Trinhduccuongdz/smart-lamp/docs/1_block_diagram.png

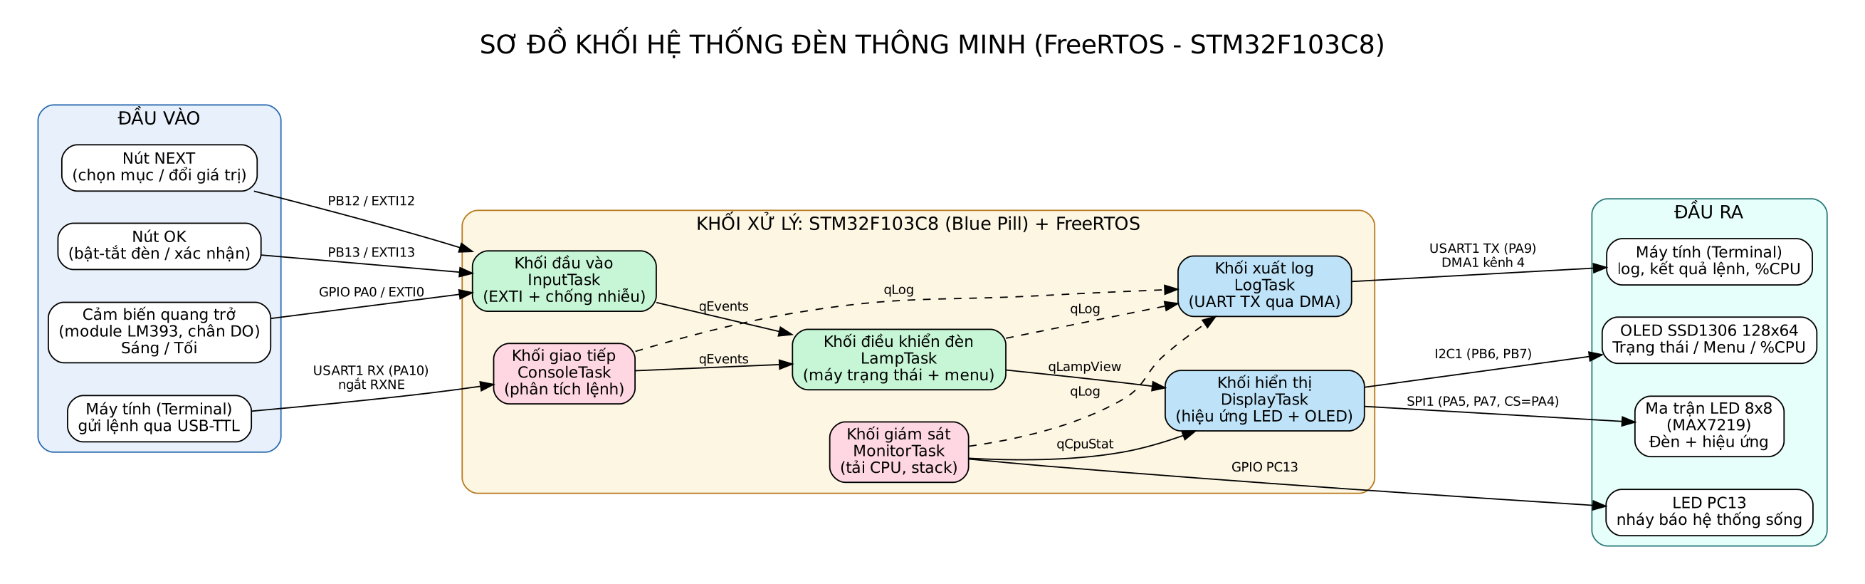
docs/1_block_diagram.png
