Trinhduccuongdz/smart-lamp/docs/2_task_ipc.png

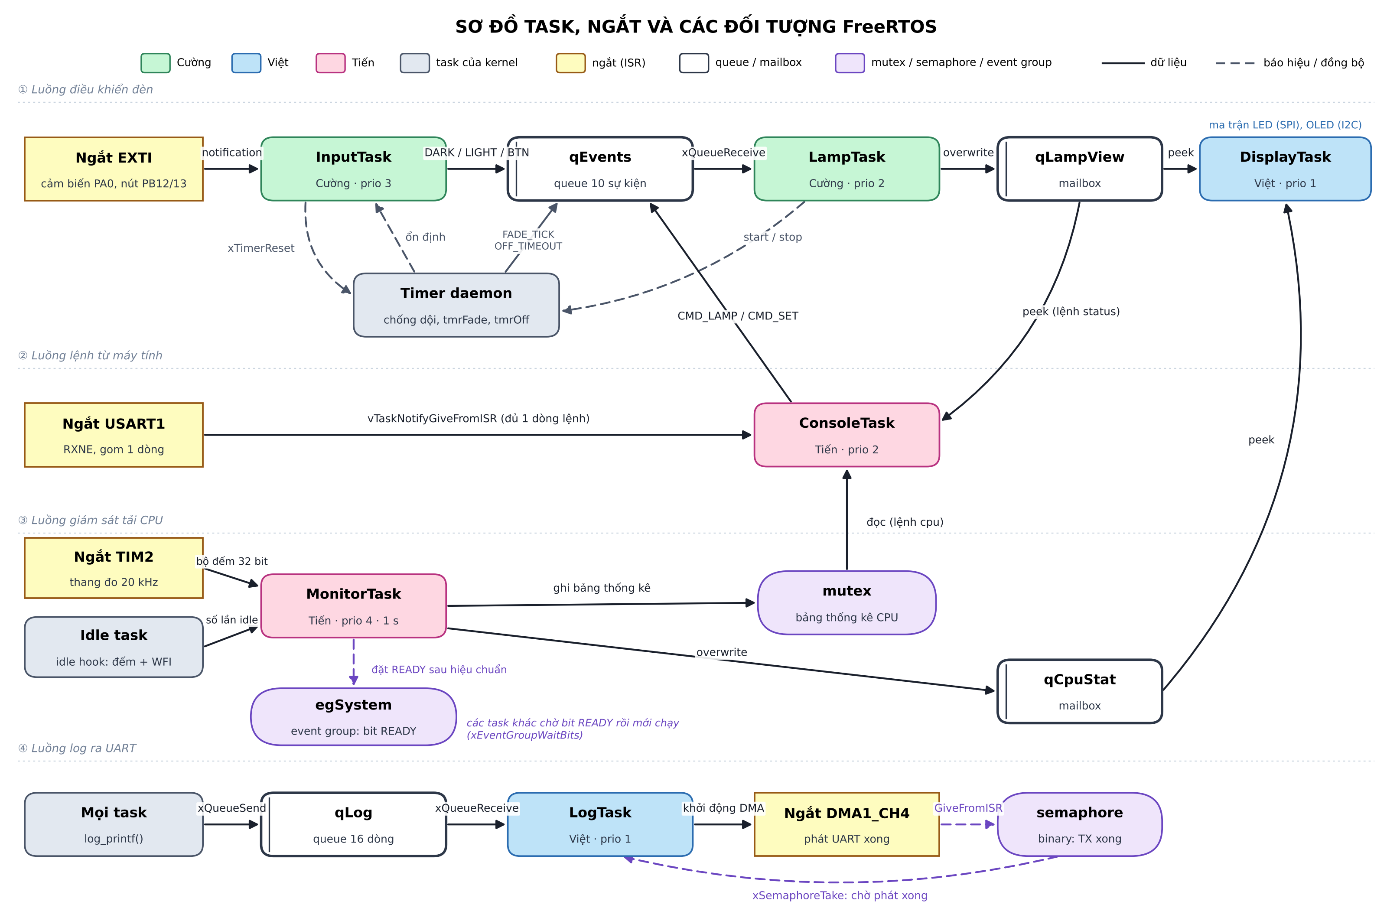
docs/2_task_ipc.png
