Trinhduccuongdz/smart-lamp/docs/3_layers.png

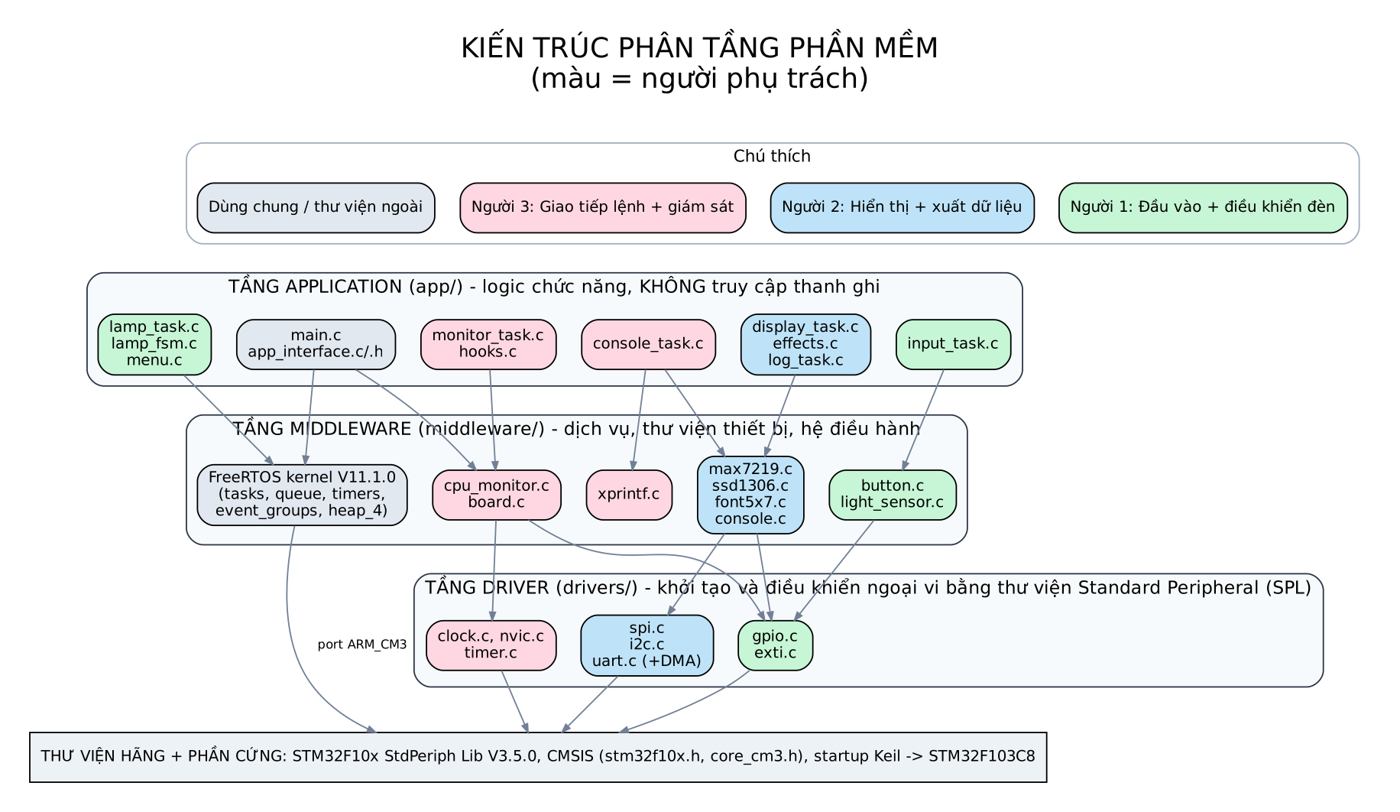
docs/3_layers.png
