Trinhduccuongdz/smart-lamp/docs/4_lamp_fsm.png

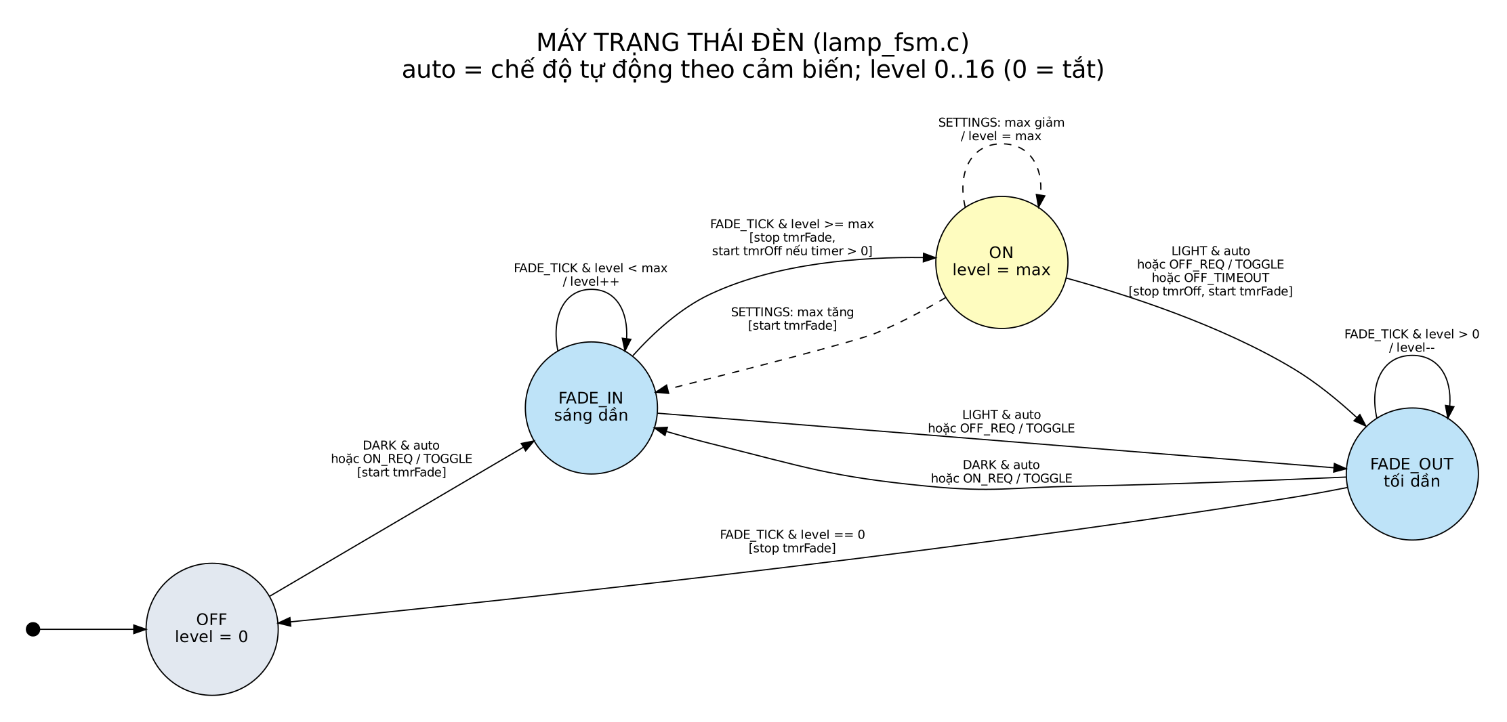
docs/4_lamp_fsm.png
