Trinhduccuongdz/smart-lamp/docs/5_flowchart.png

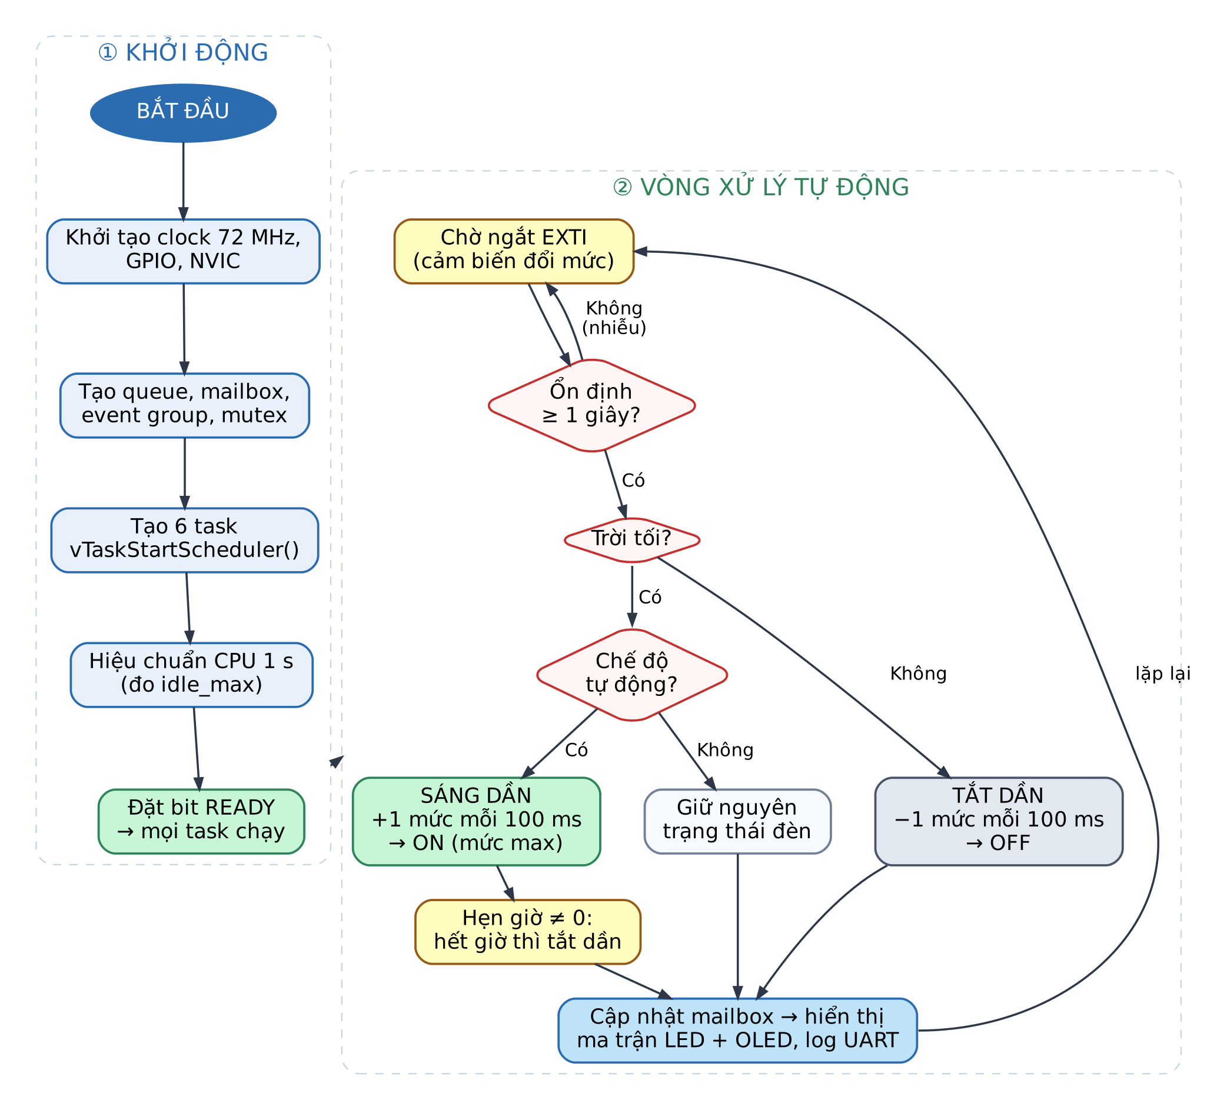
docs/5_flowchart.png
