Trinhduccuongdz/smart-lamp/docs/ctx_1_input_task.png

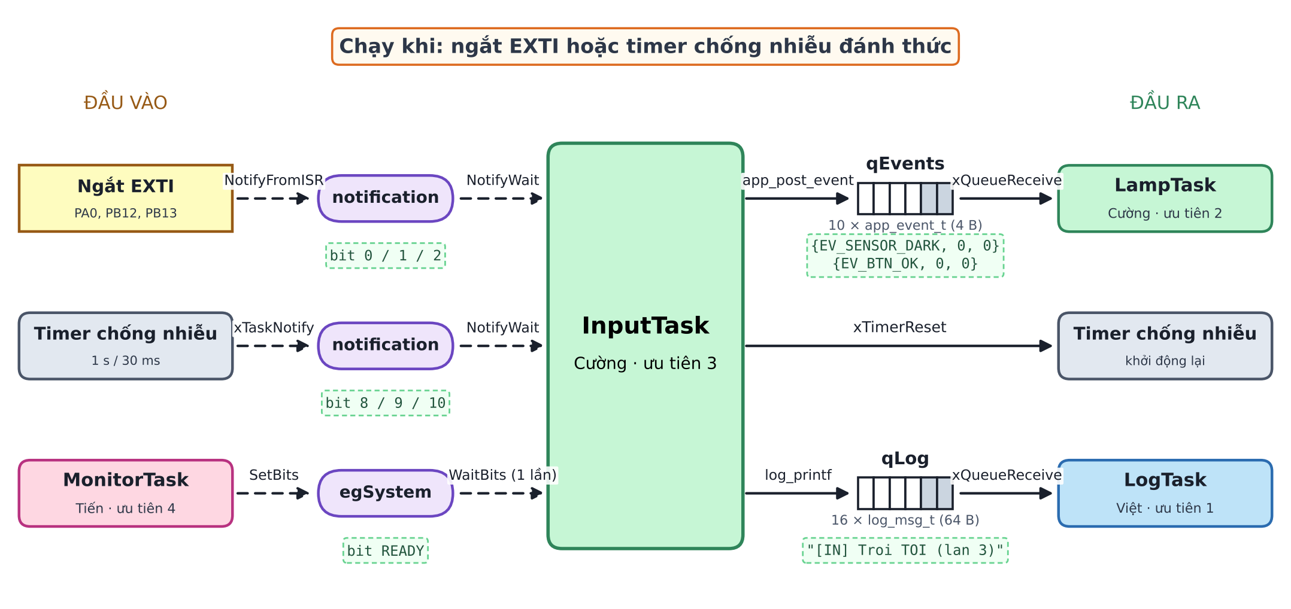
docs/ctx_1_input_task.png
