Trinhduccuongdz/smart-lamp/docs/ctx_2_lamp_task.png

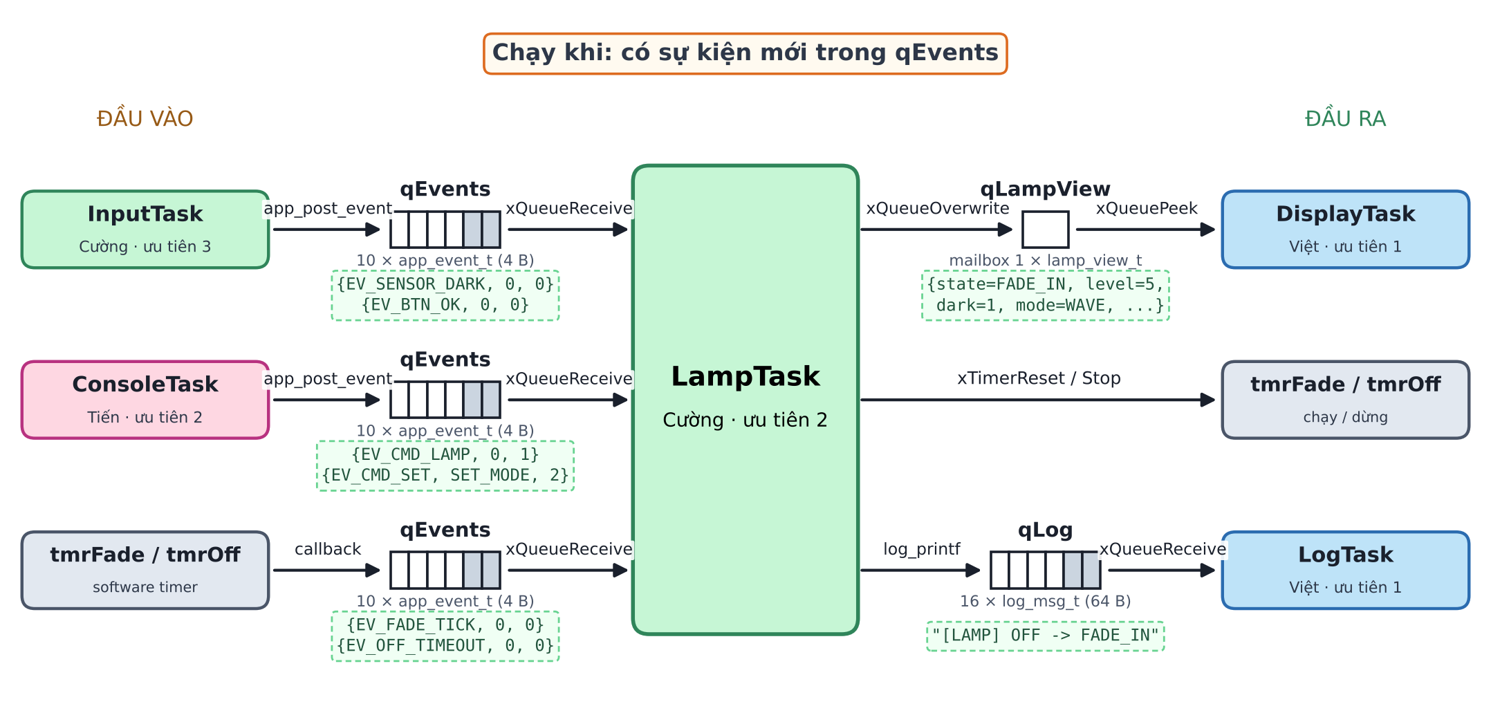
docs/ctx_2_lamp_task.png
