Trinhduccuongdz/smart-lamp/docs/ctx_3_display_task.png

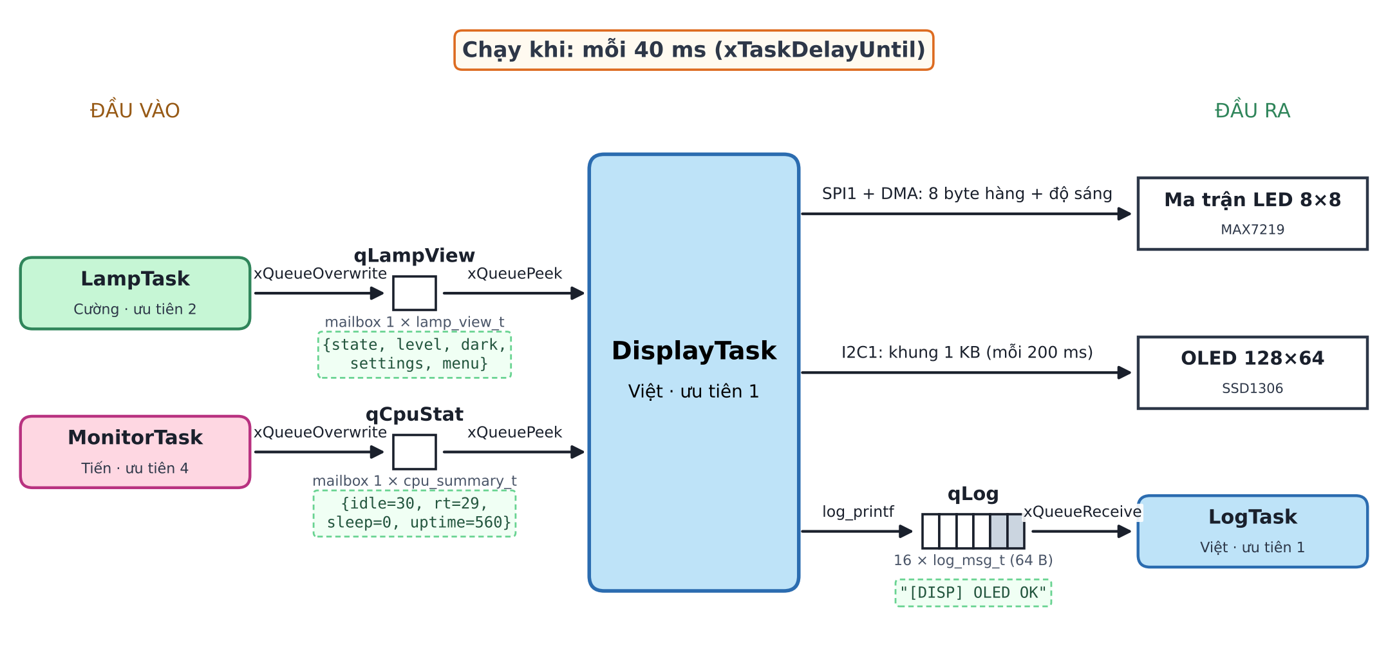
docs/ctx_3_display_task.png
