Trinhduccuongdz/smart-lamp/docs/ctx_5_log_task.png

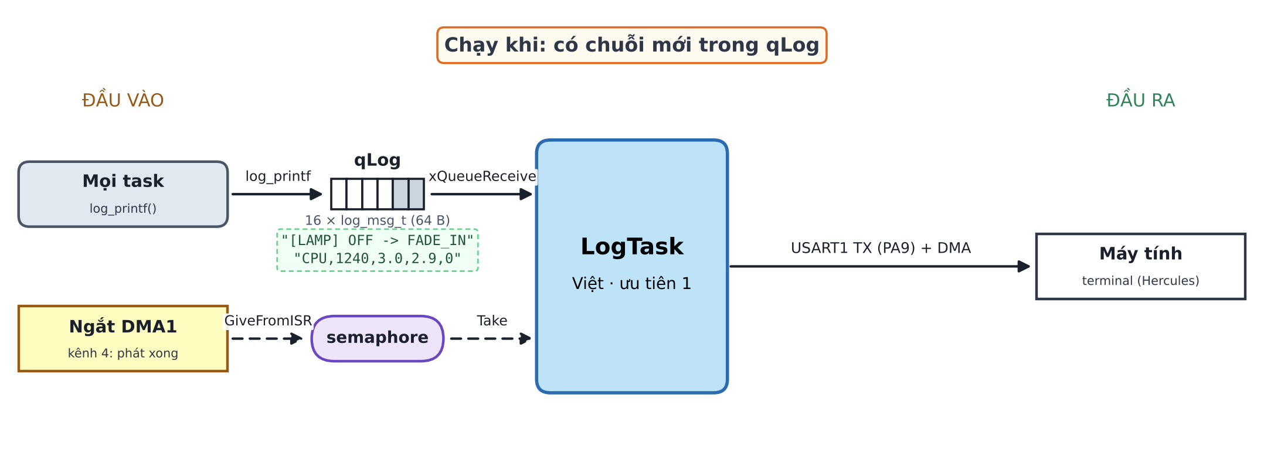
docs/ctx_5_log_task.png
