Trinhduccuongdz/smart-lamp/docs/ctx_6_monitor_task.png

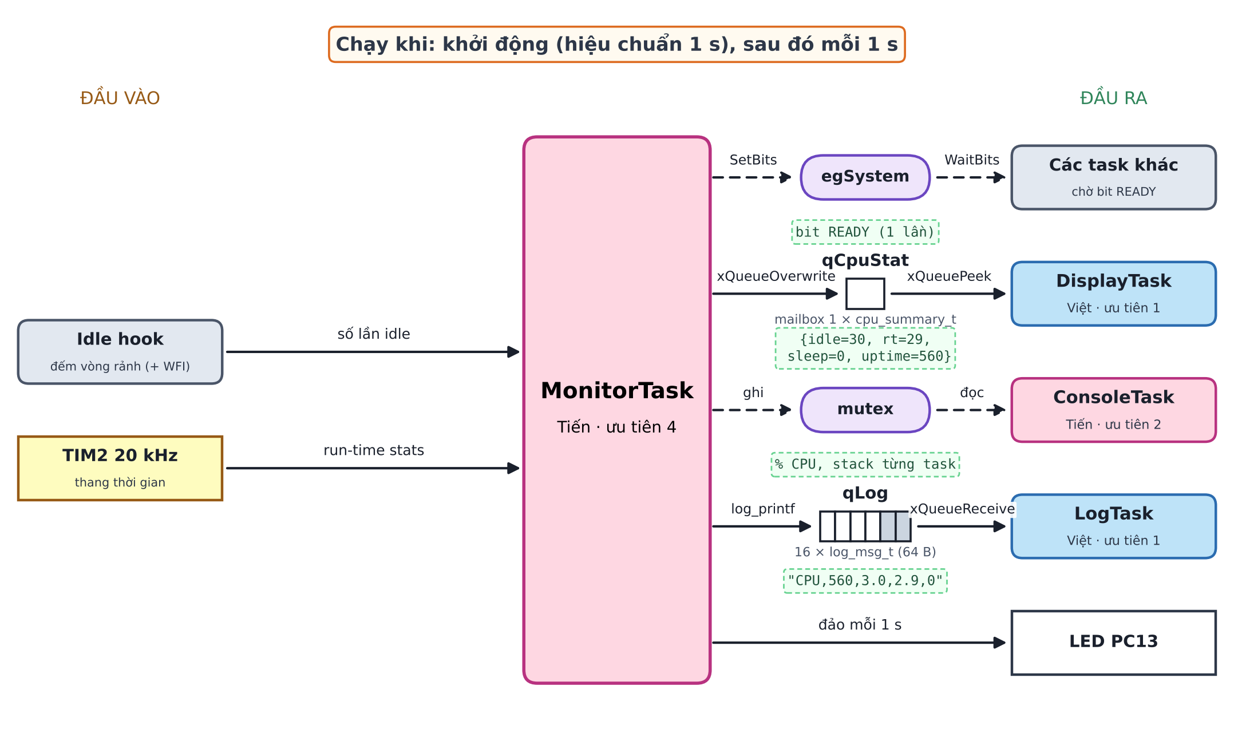
docs/ctx_6_monitor_task.png
