Trinhduccuongdz/smart-lamp/docs/flow_1_input_task.png

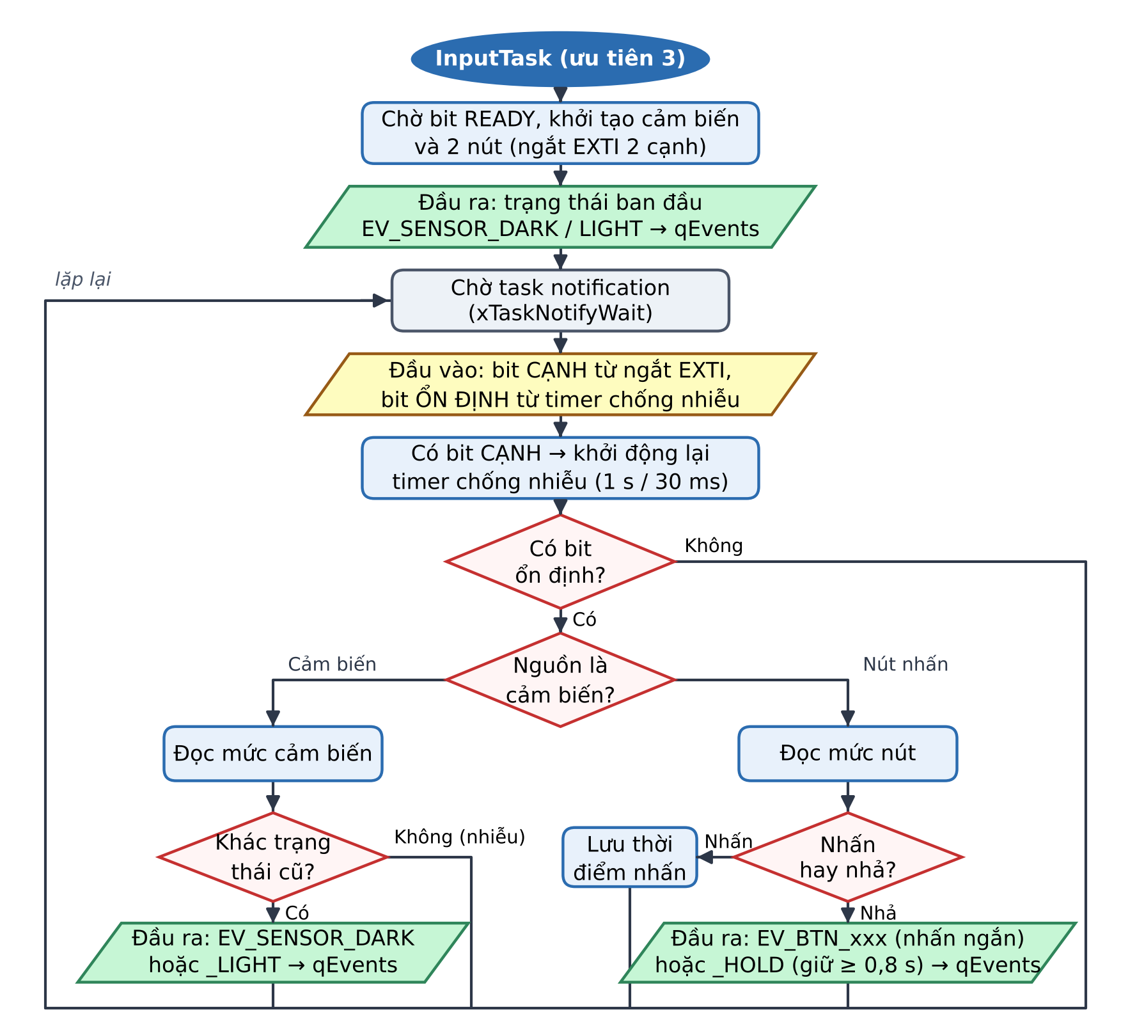
docs/flow_1_input_task.png
