Trinhduccuongdz/smart-lamp/docs/flow_2_lamp_task.png

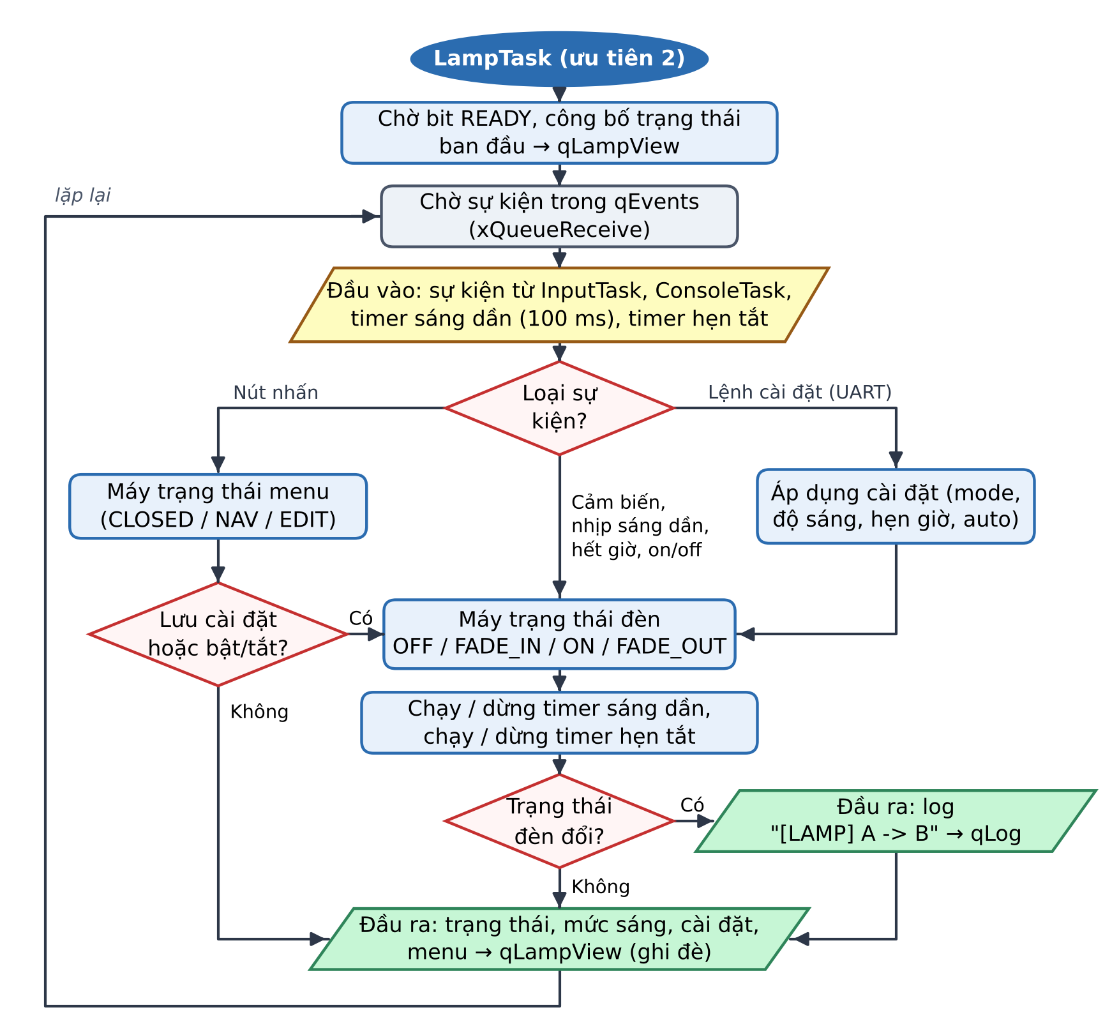
docs/flow_2_lamp_task.png
