Trinhduccuongdz/smart-lamp/docs/flow_3_display_task.png

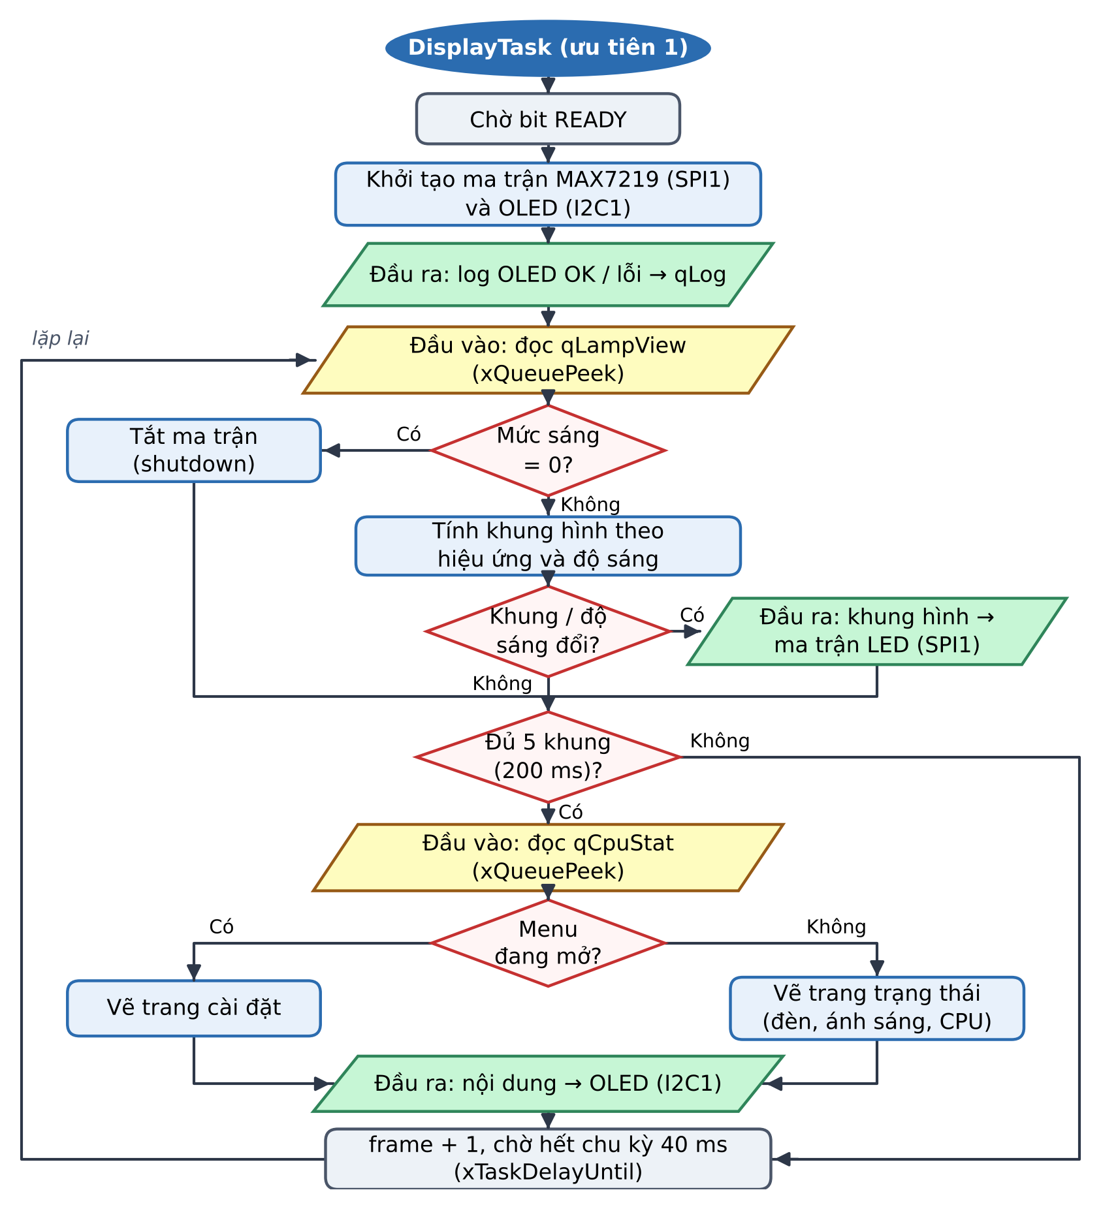
docs/flow_3_display_task.png
