Trinhduccuongdz/smart-lamp/docs/flow_4_console_task.png

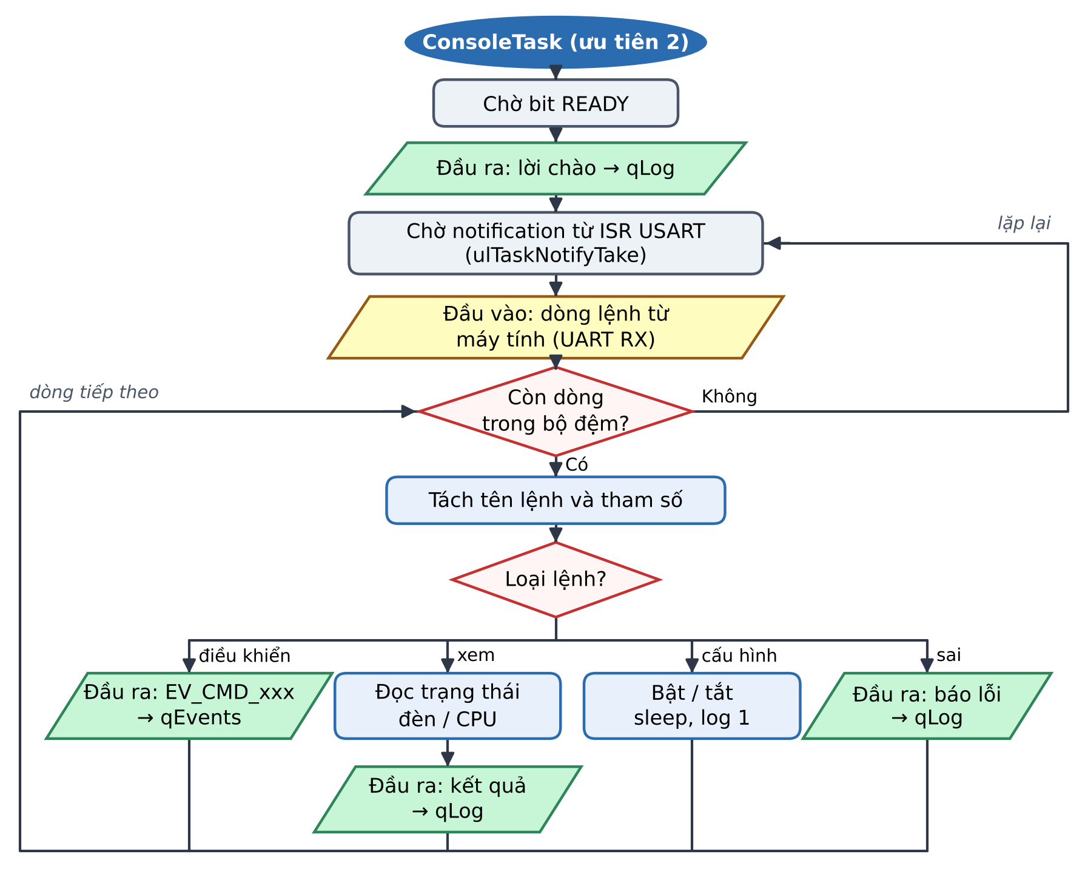
docs/flow_4_console_task.png
