Trinhduccuongdz/smart-lamp/docs/flow_5_log_task.png

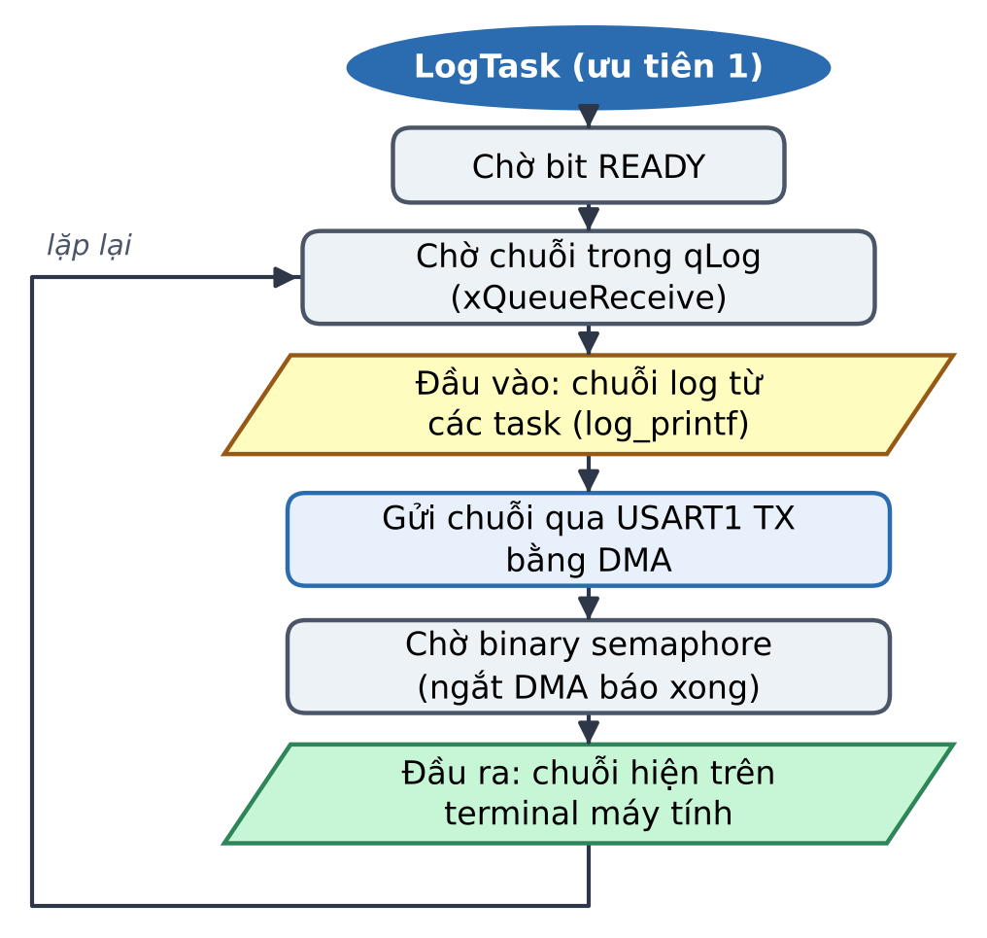
docs/flow_5_log_task.png
