Trinhduccuongdz/smart-lamp/docs/flow_6_monitor_task.png

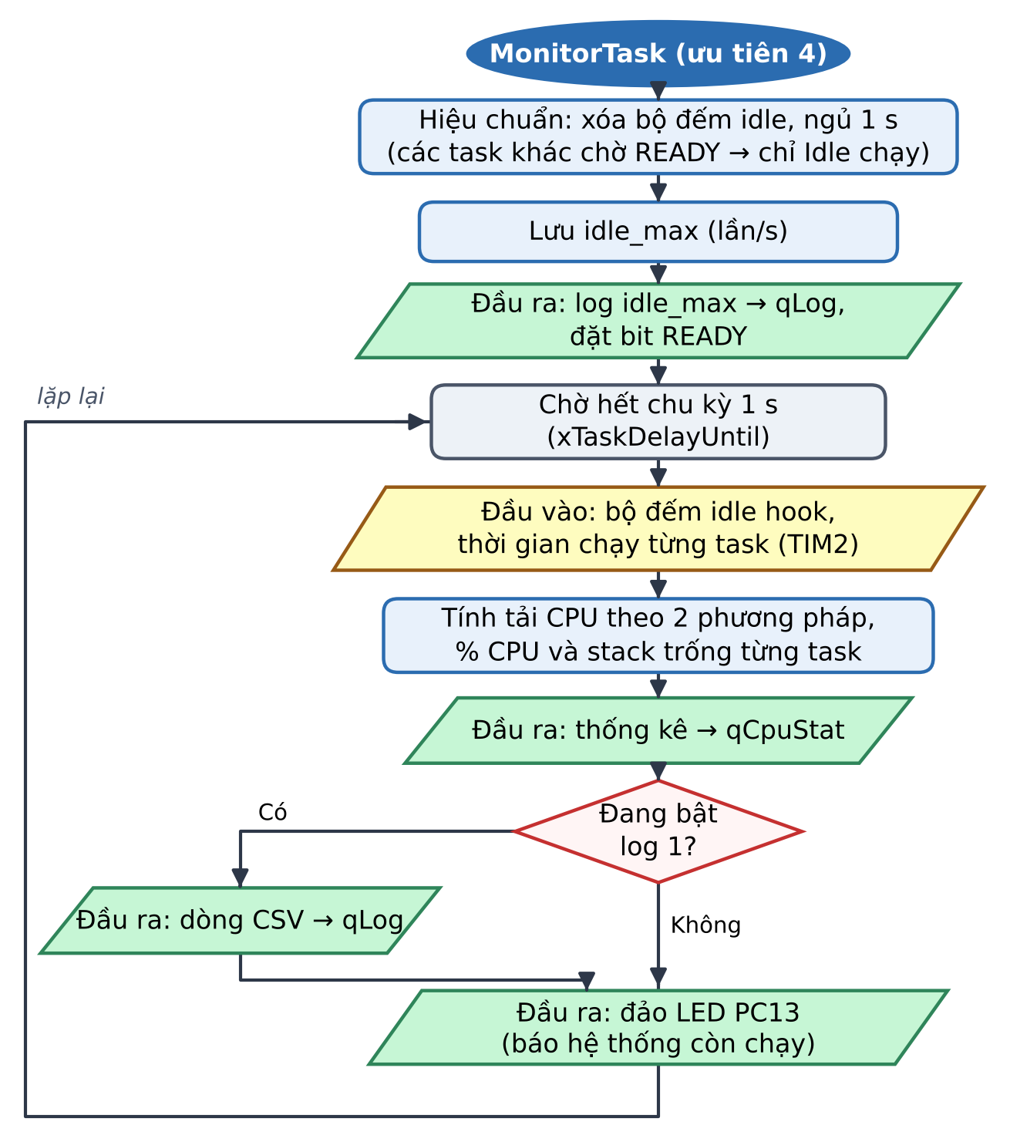
docs/flow_6_monitor_task.png
