Trinhduccuongdz/smart-lamp/docs/hw_block_diagram.png

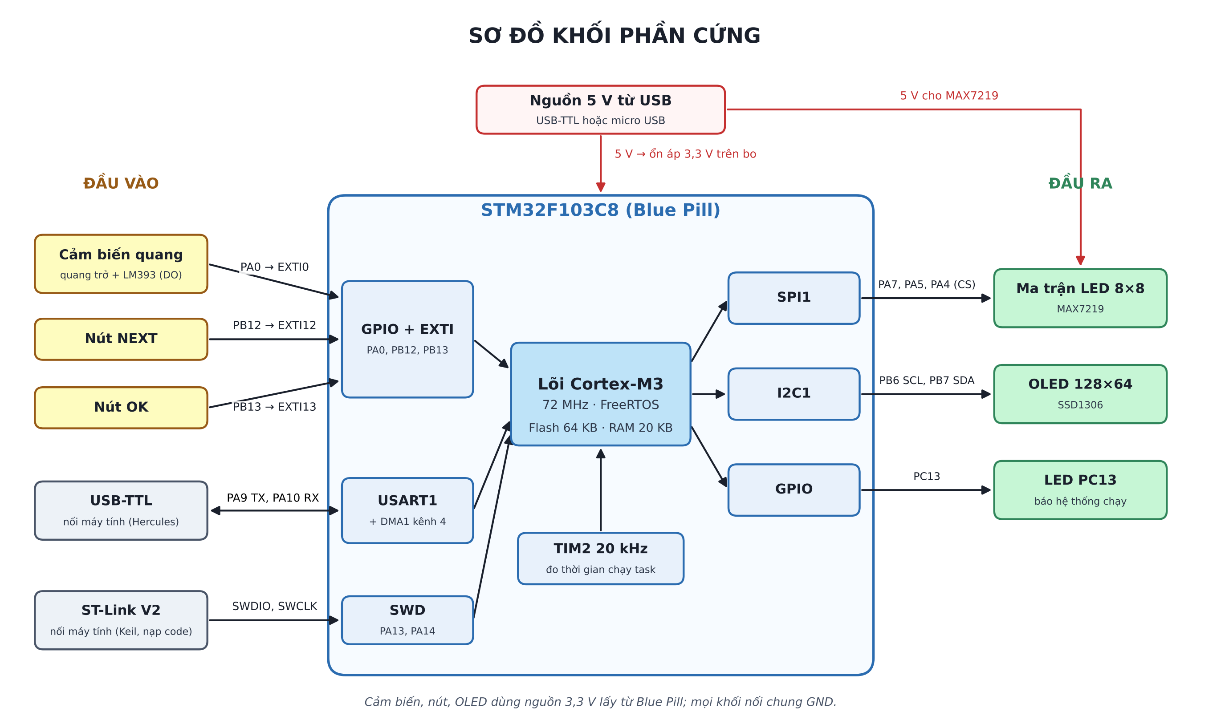
docs/hw_block_diagram.png
