Trinhduccuongdz/smart-lamp/docs/sw_block_diagram.png

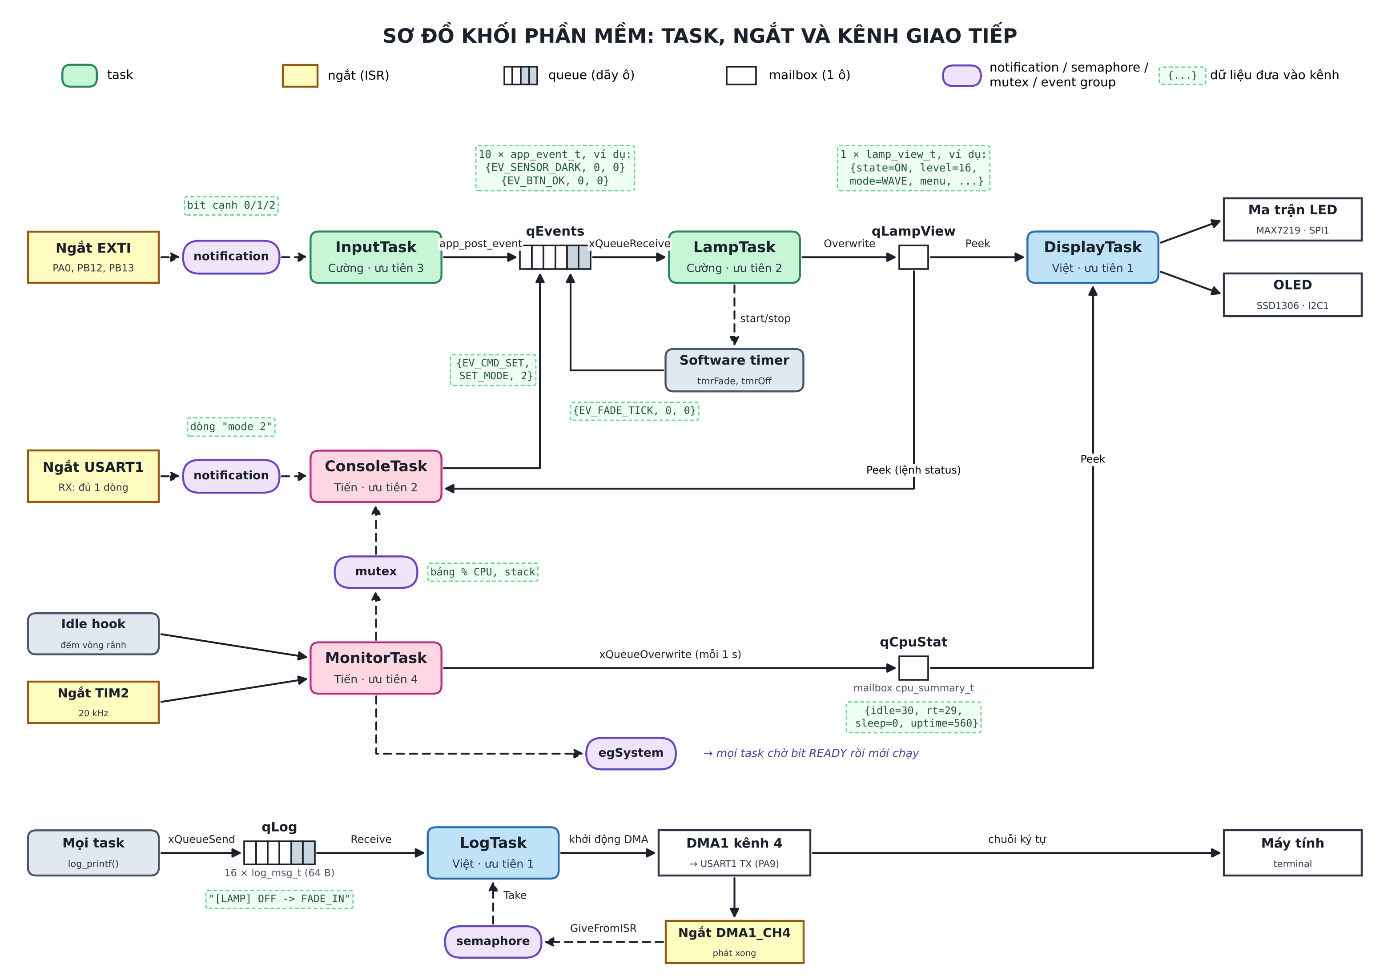
docs/sw_block_diagram.png
