Trinhduccuongdz/smart-lamp/docs/wiring.png

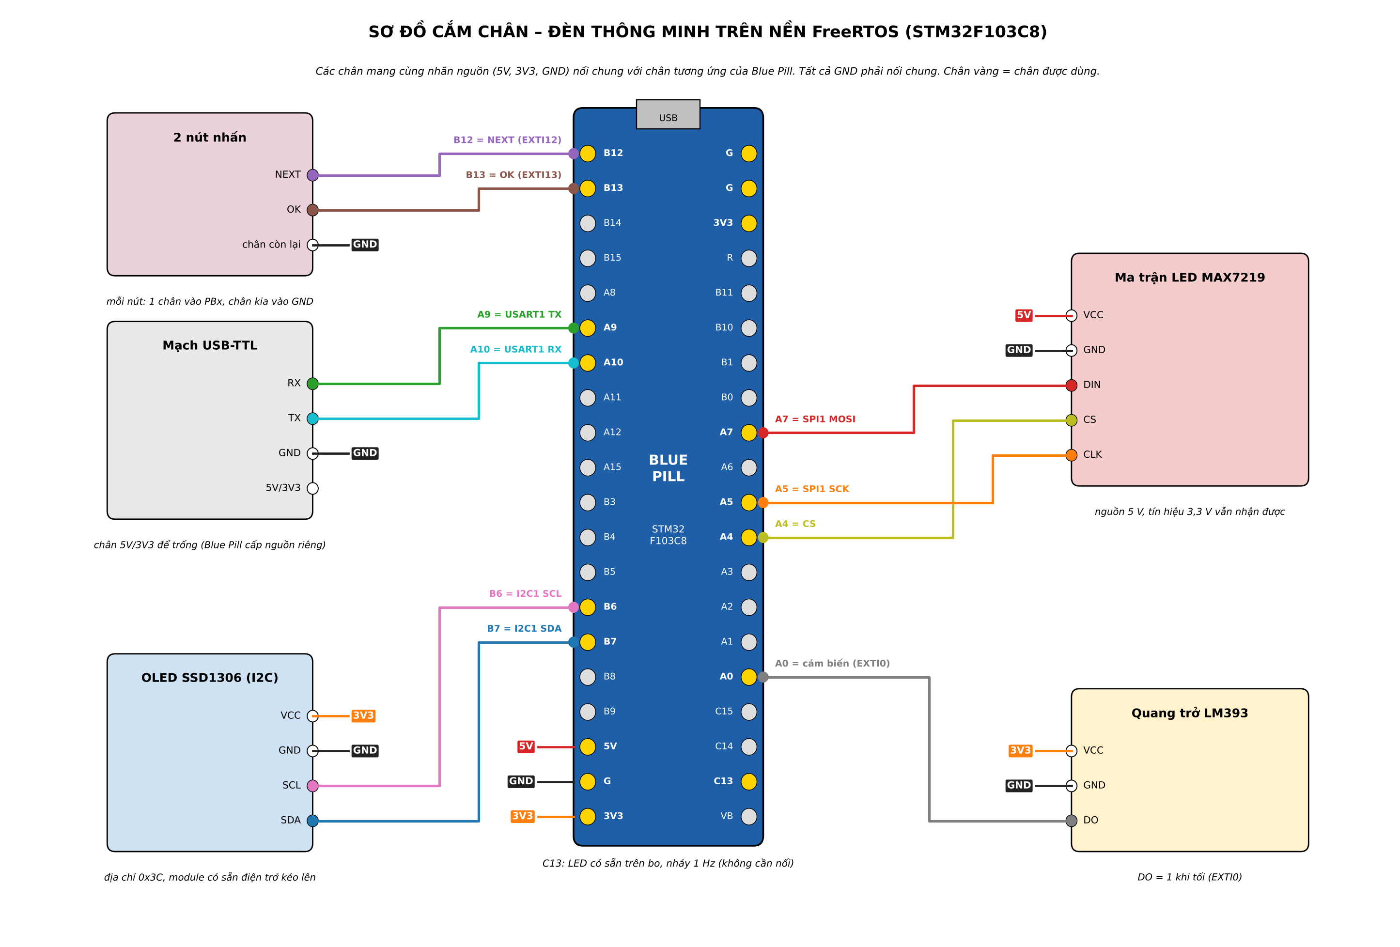
docs/wiring.png
