Trinhduccuongdz/smart-lamp/app/inc/task_console.h

/**
 * @file    task_console.h
 * @brief   [APPLICATION] Hàm khởi tạo ConsoleTask: nhận lệnh từ máy tính qua UART, chuyển thành sự kiện hoặc trả thông tin.
 * @owner   Người 3
 */
#ifndef TASK_CONSOLE_H
#define TASK_CONSOLE_H

void task_console_create(void);

#endif /* TASK_CONSOLE_H */
