Trinhduccuongdz/smart-lamp/app/inc/task_display.h

/**
 * @file    task_display.h
 * @brief   [APPLICATION] Hàm khởi tạo DisplayTask: vẽ ma trận LED (SPI1) và OLED (I2C1) từ mailbox qLampView, qCpuStat.
 * @owner   Người 2
 */
#ifndef TASK_DISPLAY_H
#define TASK_DISPLAY_H

void task_display_create(void);

#endif /* TASK_DISPLAY_H */
