Trinhduccuongdz/smart-lamp/app/inc/task_input.h

/**
 * @file    task_input.h
 * @brief   [APPLICATION] Hàm khởi tạo InputTask: đọc cảm biến quang và 2 nút, chống nhiễu, gửi sự kiện vào qEvents.
 * @owner   Người 1
 */
#ifndef TASK_INPUT_H
#define TASK_INPUT_H

void task_input_create(void);

#endif /* TASK_INPUT_H */
