Trinhduccuongdz/smart-lamp/app/inc/task_lamp.h

/**
 * @file    task_lamp.h
 * @brief   [APPLICATION] Hàm khởi tạo LampTask: máy trạng thái đèn + menu, điều khiển timer sáng/tối dần và hẹn tắt.
 * @owner   Người 1
 */
#ifndef TASK_LAMP_H
#define TASK_LAMP_H

void task_lamp_create(void);

#endif /* TASK_LAMP_H */
