Trinhduccuongdz/smart-lamp/app/inc/task_log.h

/**
 * @file    task_log.h
 * @brief   [APPLICATION] Hàm khởi tạo LogTask: gatekeeper duy nhất của USART1 TX: lấy chuỗi từ qLog, phát bằng DMA.
 * @owner   Người 2
 */
#ifndef TASK_LOG_H
#define TASK_LOG_H

void task_log_create(void);

#endif /* TASK_LOG_H */
