Trinhduccuongdz/smart-lamp/(commit log)

2026-10-29 feat(hal): gpio, exti, nut nhan, cam bien quang
2026-10-29 feat(hal): spi, i2c, MAX7219, SSD1306
2026-10-29 feat(hal): uart + DMA, timer, clock, nvic, console, cpu_monitor
